sadrash1382-pixel/usb-voltmeter/README.md

# USB-Voltmeter – 24-Bit-DC-Spannungsmesser als Arduino-Shield
 
Ein selbst entwickeltes Präzisions-Spannungsmessgerät (±10 V DC) auf Basis des
24-Bit-Delta-Sigma-ADC **ADS1220**, aufgebaut als Shield für den Arduino Uno und
per **SCPI** über USB steuerbar – wie ein Labormessgerät.
 
Das Projekt deckt die komplette Entwicklungskette ab:
**Spezifikation → Simulation (LTspice) → Schaltplan & Layout (Altium) → Fertigung (JLCPCB)
→ Firmware → Kalibrierung & messtechnische Verifikation (Python/SCPI).**
 
> Status: 🟢 Platine Rev. 1 in Betrieb, per SCPI/PyVISA fernsteuerbar – Verstärkungskalibrierung und Rev. 2 offen
 
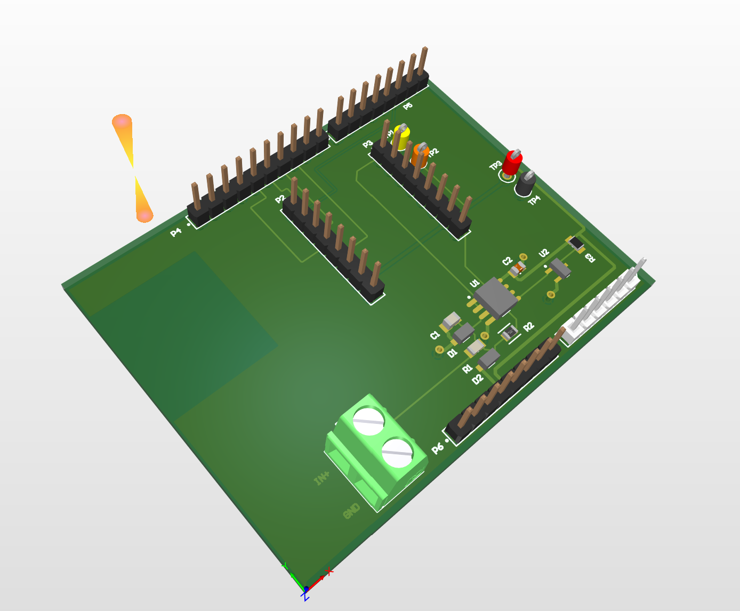
[picture p1: docs/img/shield_3d.png]
Shield 3D-Ansicht

 
---
 
## Spezifikation
 
| Parameter | Wert |
|---|---|
| Messbereich | ±10 V DC |
| Eingangswiderstand | 11 MΩ |
| ADC | TI ADS1220, 24 Bit, Delta-Sigma, interne Referenz 2,048 V |
| Netzbrummunterdrückung | 50/60 Hz simultan (Digitalfilter des ADS1220, 20 SPS) |
| Überspannungsschutz | Klemmdioden + strombegrenzender Eingangswiderstand |
| Schnittstelle | USB (virtueller COM-Port), SCPI-Befehle |
| Plattform | Arduino Uno R3 (Shield) |
 
## Schaltungskonzept
 
```
IN ──R1 10M──┬── NODE ──[U1A Puffer]── OUT ──► ADS1220 AIN0
             │                                    (differentiell)
           R2 1M   C1 10n   D1/D2 (Klemmung)
             │                                    
REF ◄──[U1B Puffer]── REF_RAW ◄── LM4040 2,5 V ──► ADS1220 AIN1
```
 
- **Teiler mit Fußpunkt an 2,5 V:** Bipolare Eingangsspannungen werden auf den
  Bereich 0…5 V der Einzelversorgung abgebildet.
  $V_\text{node} = V_\text{ref} + \frac{V_\text{in}-V_\text{ref}}{11}$
- **Differentielle Messung** zwischen OUT und REF:
  $V_\text{in} = 11 \cdot V_\text{diff} + V_\text{ref}$
- **CMOS-Puffer (MCP6002)** mit pA-Eingangsruhestrom, da der Knoten ≈ 0,91 MΩ
  Innenwiderstand hat.
- **RC-Tiefpass** aus Teiler-Innenwiderstand und C1 (C0G), f_g ≈ 17,5 Hz.
- **Kalibrierung:** $V_\text{kal} = a \cdot V_\text{roh} + b$ (Verstärkungs- und Offsetfehler).
## Simulation (LTspice)
 
Jede Stufe wurde einzeln simuliert und mit einer Handrechnung verglichen:
 
| Untersuchung | Ergebnis |
|---|---|
| DC-Übertragung des Teilers | ✅ wie berechnet |
| Einfluss Op-Amp-Eingangswiderstand (500 MΩ vs. 1 TΩ) | Verstärkungsfehler ±20 mV → ±50 µV |
| Einfluss Eingangsruhestrom (1 nA vs. 1 pA) | Offset 9 mV → 9 µV |
| Frequenzgang Filter | f_g = 17,66 Hz (berechnet 17,7 Hz) |
| Überspannung 30 V / 60 V | Knoten auf ≈ 5,2 / 5,3 V geklemmt, Diodenstrom ≈ 0,1 / 3 µA |
| Monte-Carlo, 0,1 %-Widerstände | Verstärkungsfehler bis ≈ 0,14 % → Kalibrierung nötig |
 
**Erkenntnis:** Das Fehlerbudget wird von Bauteiltoleranzen (mV-Bereich) dominiert,
nicht von der Schaltungstopologie (µV-Bereich).
 
> Hinweis: Simuliert wurde mit R1 = 9 MΩ (Teiler 1:10). Gefertigt wird mit R1 = 10 MΩ
> (Teiler 1:11, Eingangswiderstand 11 MΩ), weil 9,1 MΩ in 0805 nicht lieferbar war.
> Die Fehlermechanismen und Größenordnungen bleiben gleich.
 
Dateien und Plots: [`simulation/`](simulation/)
 
## Hardware
 
- Schaltplan: [`hardware/USB-Voltmeter_Schematic.pdf`](hardware/USB-Voltmeter_Schematic.pdf)
- Layout: 2 Lagen, 68,6 × 53,3 mm, durchgehende GND-Fläche auf der Unterseite,
  Sperrfläche über der USB-Buchse des Uno
- Stückliste: [`hardware/BOM.csv`](hardware/BOM.csv)
- Fertigungsdaten (Gerber/Drill für JLCPCB): [`hardware/fabrication/`](hardware/fabrication/)
- Passvorlage 1:1 zur mechanischen Prüfung auf dem Uno: [`hardware/fabrication/`](hardware/fabrication/)
| Oberseite | Unterseite |
|---|---|
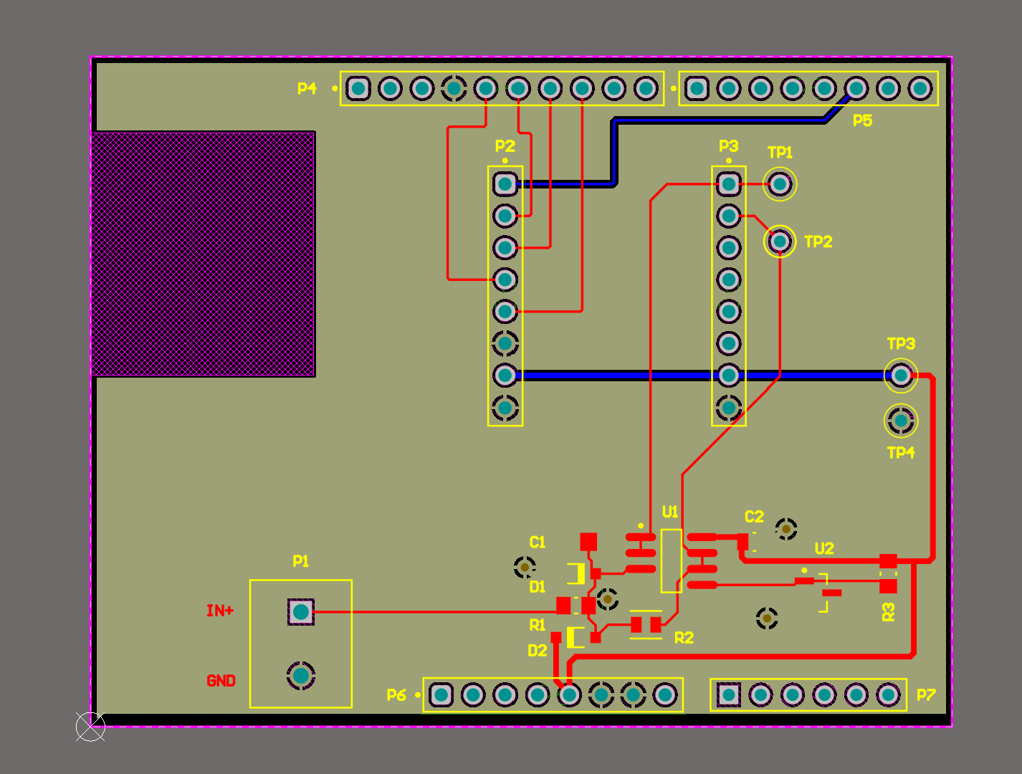
[picture p2: docs/img/layout_top.png]
Top
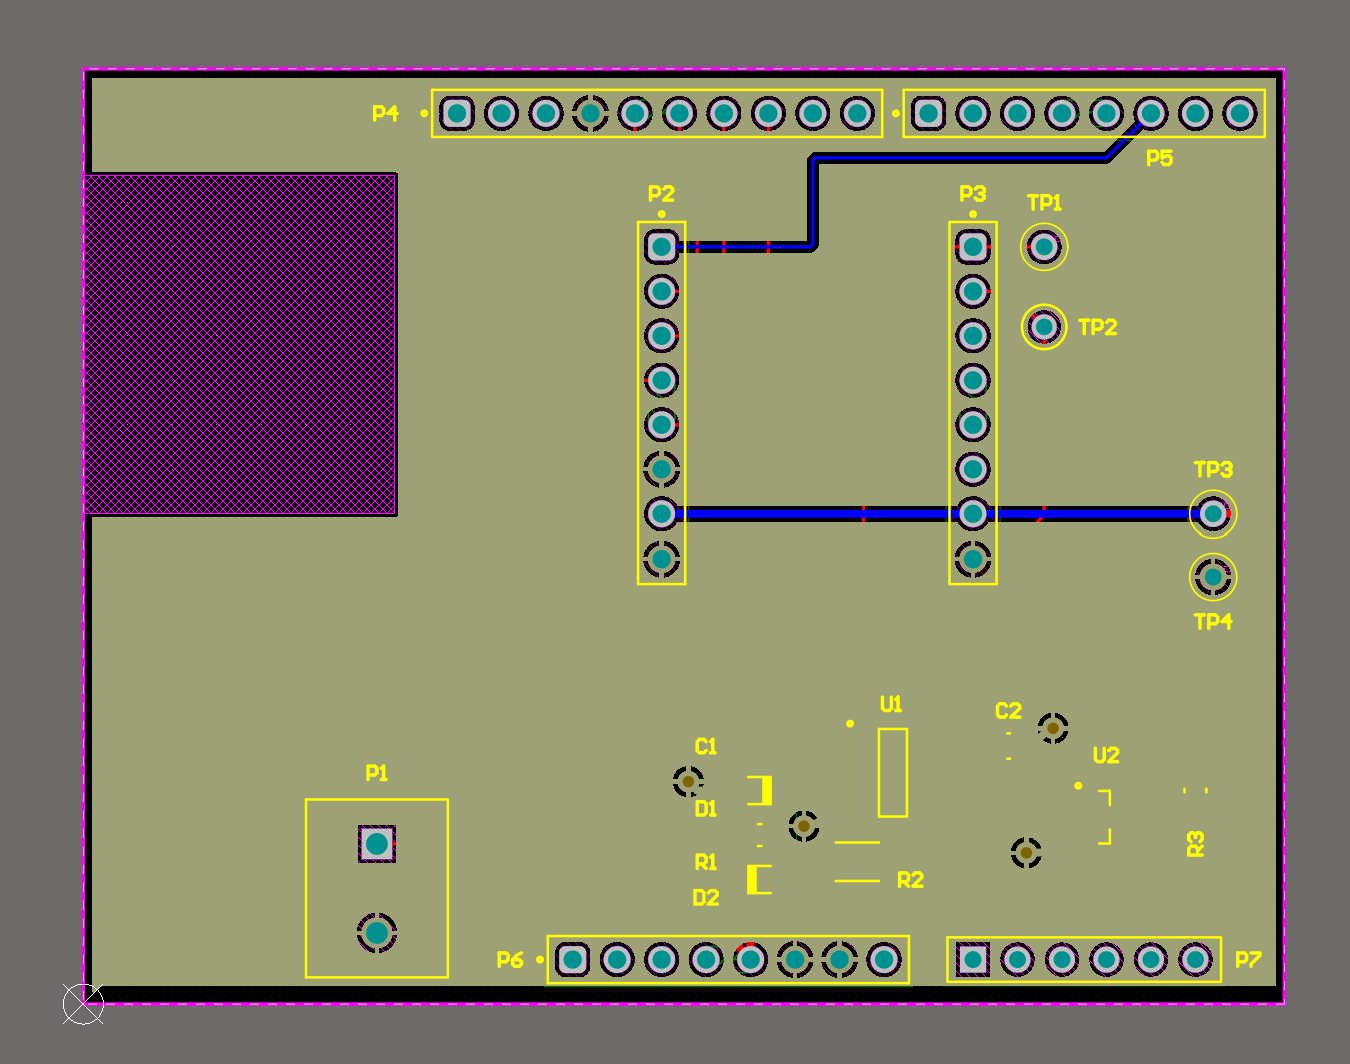
[picture p3: docs/img/layout_bottom.png]
Bottom
|  |  |
 
## Firmware
 
| Sketch | Zweck |
|---|---|
| [`firmware/spi_diagnose`](firmware/spi_diagnose) | SPI-Test ohne Library: Register schreiben/zurücklesen, läuft in Schleife zum Messen mit dem Oszilloskop |
| [`firmware/ads1220_test`](firmware/ads1220_test) | Messung AIN0 gegen AVSS, Ausgabe von Mittelwert und Rauschen |
| [`firmware/voltmeter_rev1`](firmware/voltmeter_rev1) | Firmware für Platine Rev. 1: Software-SPI (Workaround für Header-Versatz), differentielle Messung OUT − REF, Offset-Kalibrierung |
| [`firmware/voltmeter_scpi`](firmware/voltmeter_scpi) | **SCPI-Firmware:** misst auf Anfrage (`*IDN?`, `MEAS:VOLT:DC?`, `CALC:SDEV?`), Mittelung und Kalibrierung per Befehl, Kalibrierung im EEPROM, SCPI-Fehlerspeicher |

Befehlsübersicht und Automatisierung: [`docs/scpi-automatisierung.md`](docs/scpi-automatisierung.md)

**Python/PyVISA:** [`scripts/kennlinie.py`](scripts/kennlinie.py) steuert Labornetzteil (OWON SPE3051) und Voltmeter gemeinsam per SCPI, fährt eine Spannungsrampe und erzeugt CSV und Linearitätsplot.
 
## Messergebnisse
 
### Breadboard-Test des ADS1220 → [ausführlich](docs/breadboard-test.md)

| Messung | Ergebnis |
|---|---|
| Rauschen, Eingang kurzgeschlossen (20 SPS) | **3,5 µV<sub>rms</sub>** (Datenblatt: 3,89 µV<sub>rms</sub>) |
| Effektive Auflösung (2,048 V Bereich) | **≈ 19,2 Bit** rms, ≈ 16,5 Bit rauschfrei |
| Rauschen mit Labornetzteil am Eingang | ≈ 25 µV<sub>rms</sub> → von der Quelle dominiert |
| 0,5 V vom Netzteil | 499,94 mV (Multimeter: 500 mV) |

Bei der Inbetriebnahme wurde ein Kontaktfehler auf der MISO-Leitung mit dem
Oszilloskop eingegrenzt: SPI-Signale Schritt für Schritt vom Uno bis zum Chip und
zurück verfolgt.

### Platine Rev. 1 → [ausführlich](docs/inbetriebnahme-rev1.md)

| Messung | Ergebnis |
|---|---|
| Rauschen am Eingang (Einzelwandlung, 20 SPS) | **≈ 80 µV<sub>rms</sub>** |
| Effektive Auflösung (Messbereich ±10 V) | **≈ 17,9 Bit** |
| Offset vor / nach Kalibrierung | 17,1 mV / 0 mV |
| Abweichung zum Handmultimeter VC97 (1–9 V) | ≤ 9 mV, Verstärkung 0,15–0,19 % unter VC97 – innerhalb dessen Unsicherheit |

Rev. 1 hat einen Layoutfehler (Digitalheader 100 mil versetzt), der per Teilbestückung
und Software-SPI umgangen ist. Vier Bestückungs- und Kontaktfehler wurden über die
Testpunkte stufenweise eingegrenzt und behoben.

### Automatisierte Kennlinie → [ausführlich](docs/scpi-automatisierung.md)

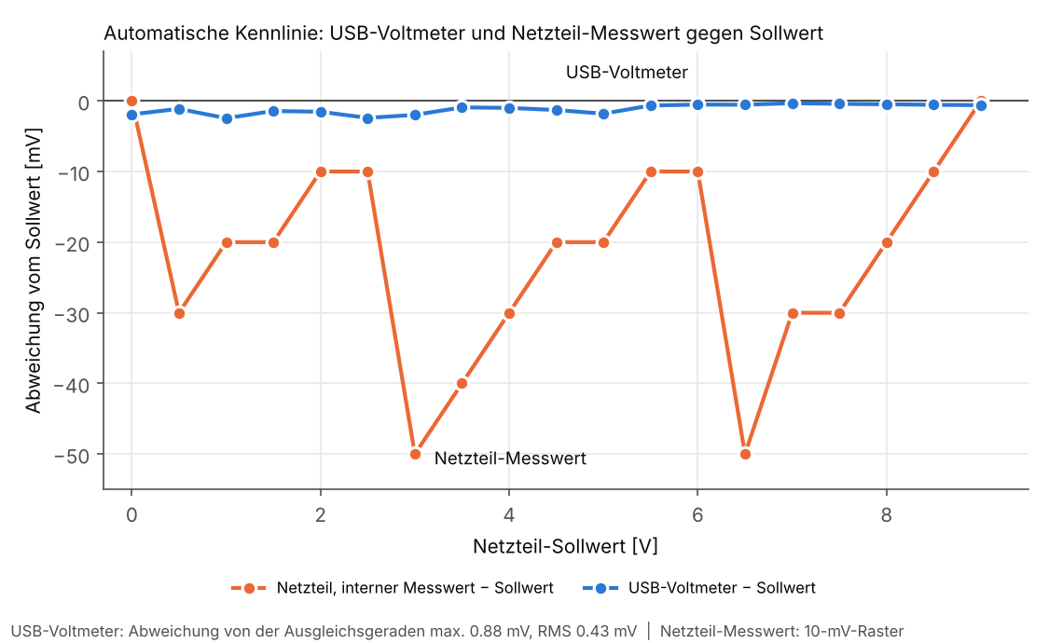
[picture p4: docs/img/rev1/kennlinie_auto.png]
Automatische Kennlinie


| Messung | Ergebnis |
|---|---|
| Nichtlinearität 0 … 9 V (gegen Netzteil-Sollwert) | **< 1 mV max., RMS 0,44 mV** in zwei Läufen, Obergrenze (Muster deutet auf den Netzteil-DAC) |
| Abweichung vom Netzteil-Sollwert | −2,5 … −0,3 mV |

Nebenbefund: Das Voltmeter ist genauer als die interne Spannungsmessung des
Netzteils (10-mV-Raster, Fehler bis −50 mV).

TODO – Verstärkungskalibrierung mit Tischmultimeter, negative Spannungen, Rev. 2
 
## Repository-Struktur
 
```
├── docs/            Konzept, Herleitungen, Bilder
├── simulation/      LTspice-Dateien (.asc) und Plots
├── hardware/        Altium-Projekt, Schaltplan-PDF, BOM, Gerber
├── firmware/        Arduino-Sketch
├── scripts/         Python: SCPI-Steuerung, Kalibrierung, Auswertung
└── measurements/    Rohdaten (.csv) und Auswertungen
```
 
## Autor
 
Amirsadra Shahanjarini – M.Sc. Elektrotechnik, TU München
