sadrash1382-pixel/usb-voltmeter/docs/img/ads1220_modul.jpg

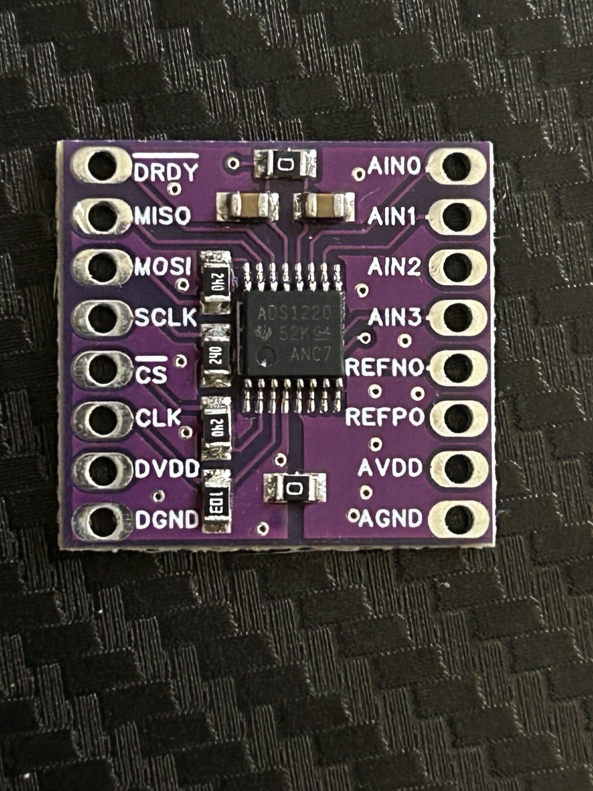
docs/img/ads1220_modul.jpg
