sadrash1382-pixel/usb-voltmeter/docs/img/bohrungen.png

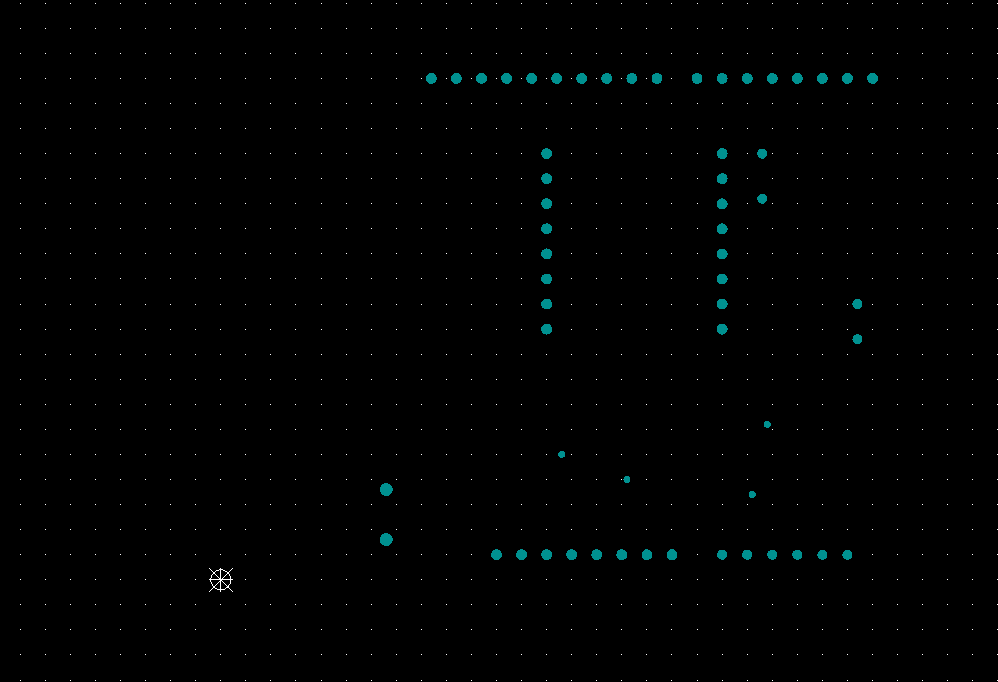
docs/img/bohrungen.png
