sadrash1382-pixel/usb-voltmeter/simulation/01_teiler_dc_sweep.png

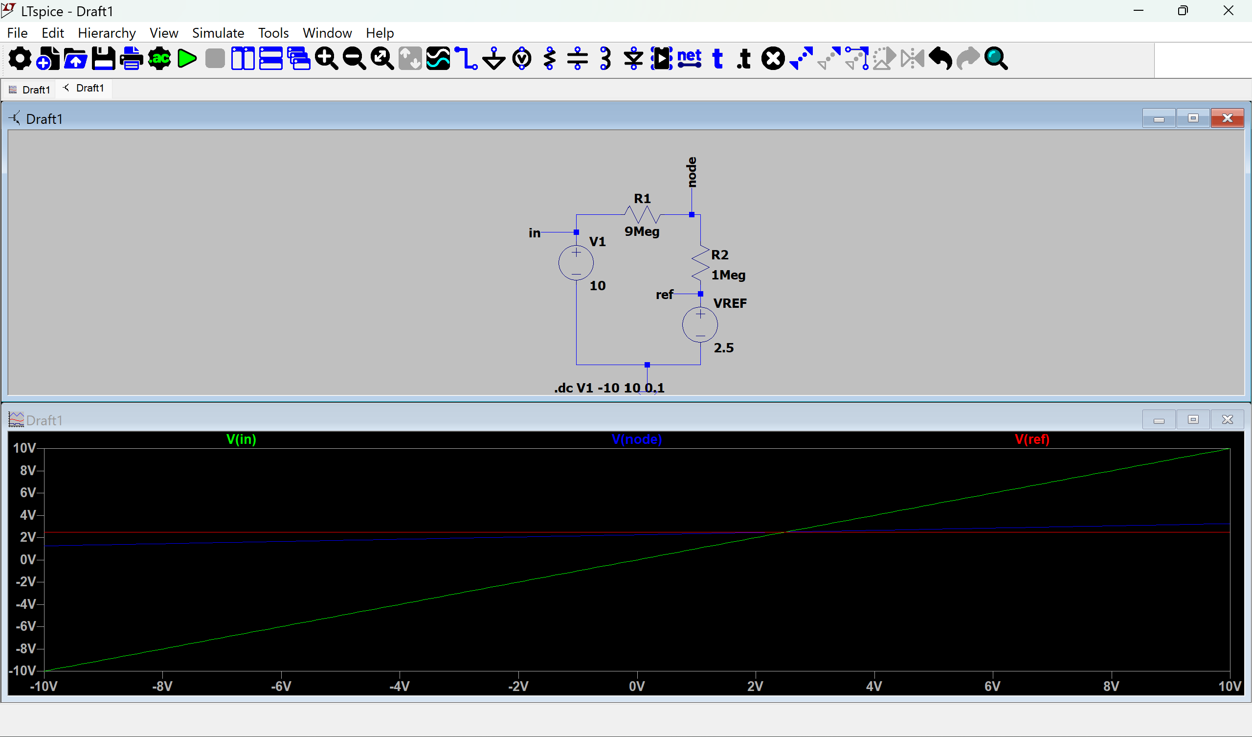
simulation/01_teiler_dc_sweep.png
