sadrash1382-pixel/usb-voltmeter/simulation/02_frontend_schaltung.png

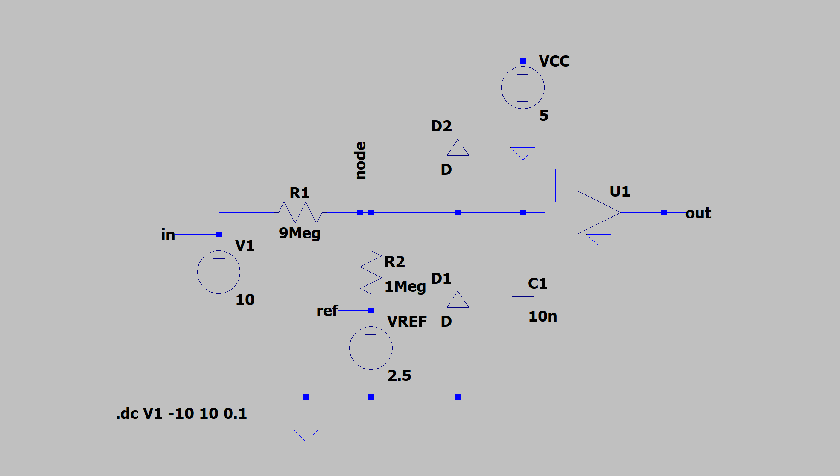
simulation/02_frontend_schaltung.png
