sadrash1382-pixel/usb-voltmeter/simulation/03_fehler_rin_500M.png

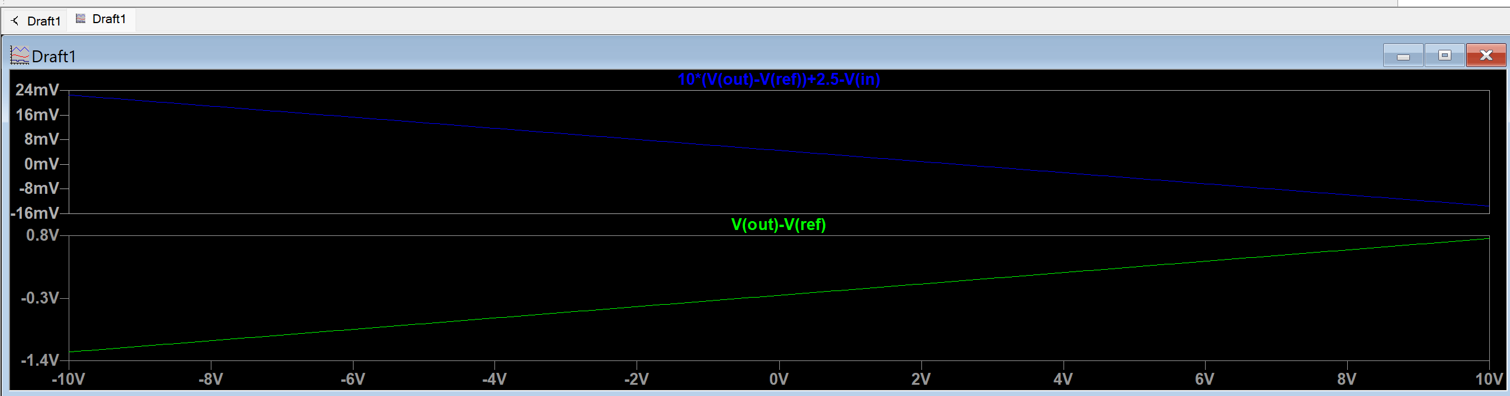
simulation/03_fehler_rin_500M.png
