sadrash1382-pixel/usb-voltmeter/simulation/04_fehler_rin_1T.png

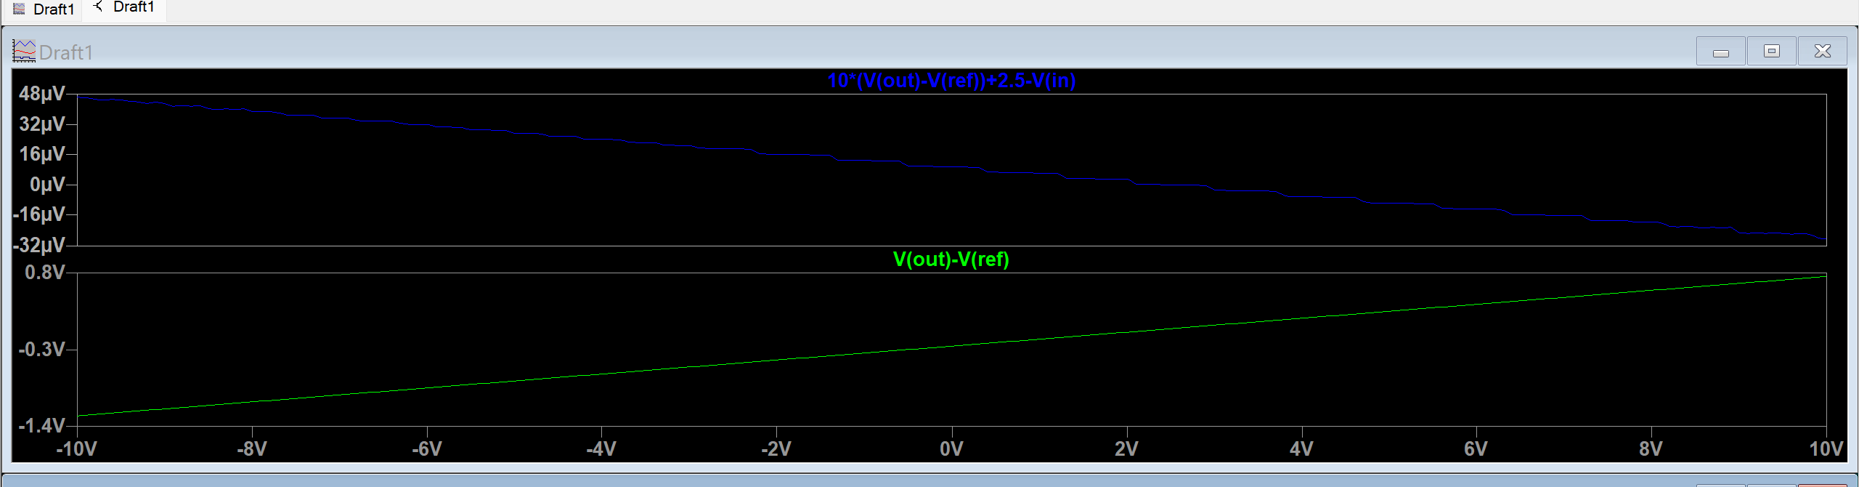
simulation/04_fehler_rin_1T.png
