sadrash1382-pixel/usb-voltmeter/simulation/05_offset_ib_1nA.png

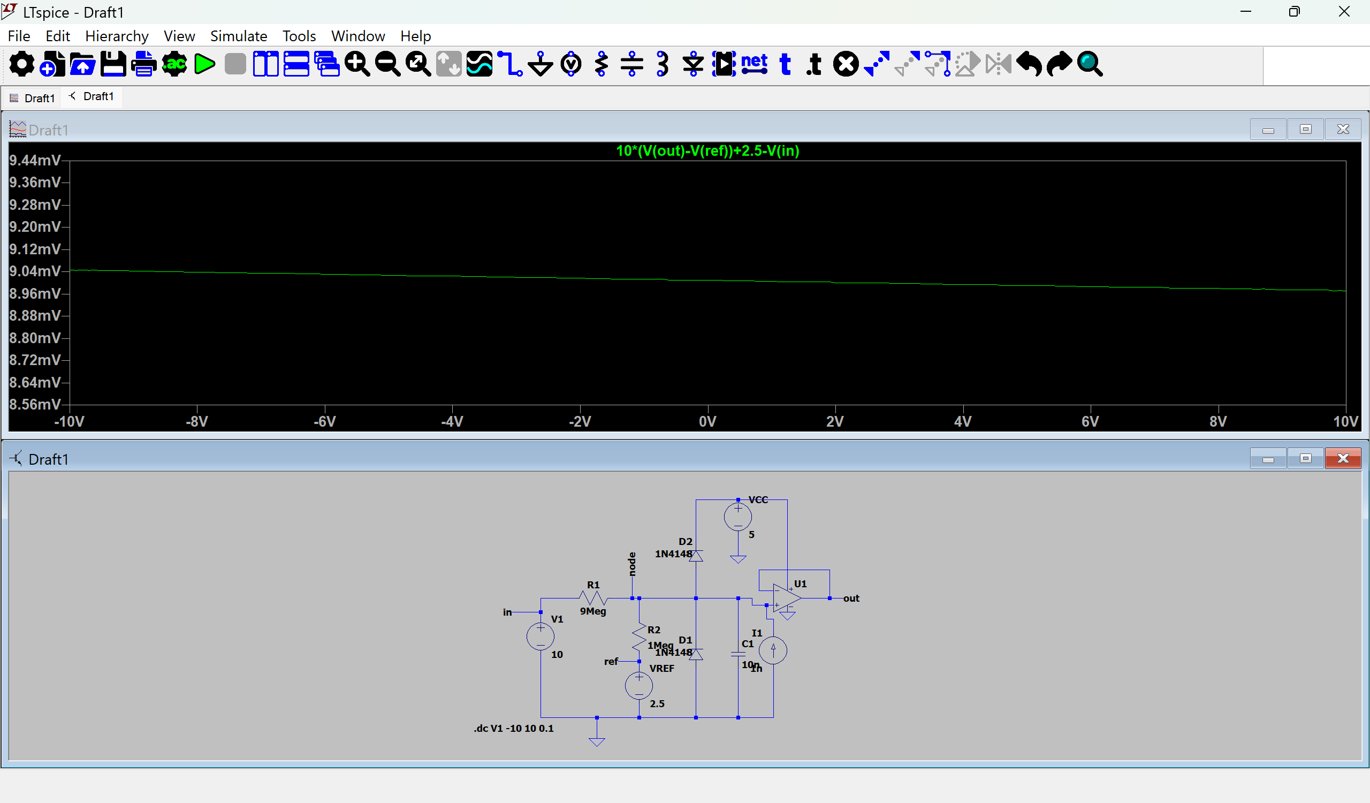
simulation/05_offset_ib_1nA.png
