sadrash1382-pixel/usb-voltmeter/simulation/06_offset_ib_1pA.png

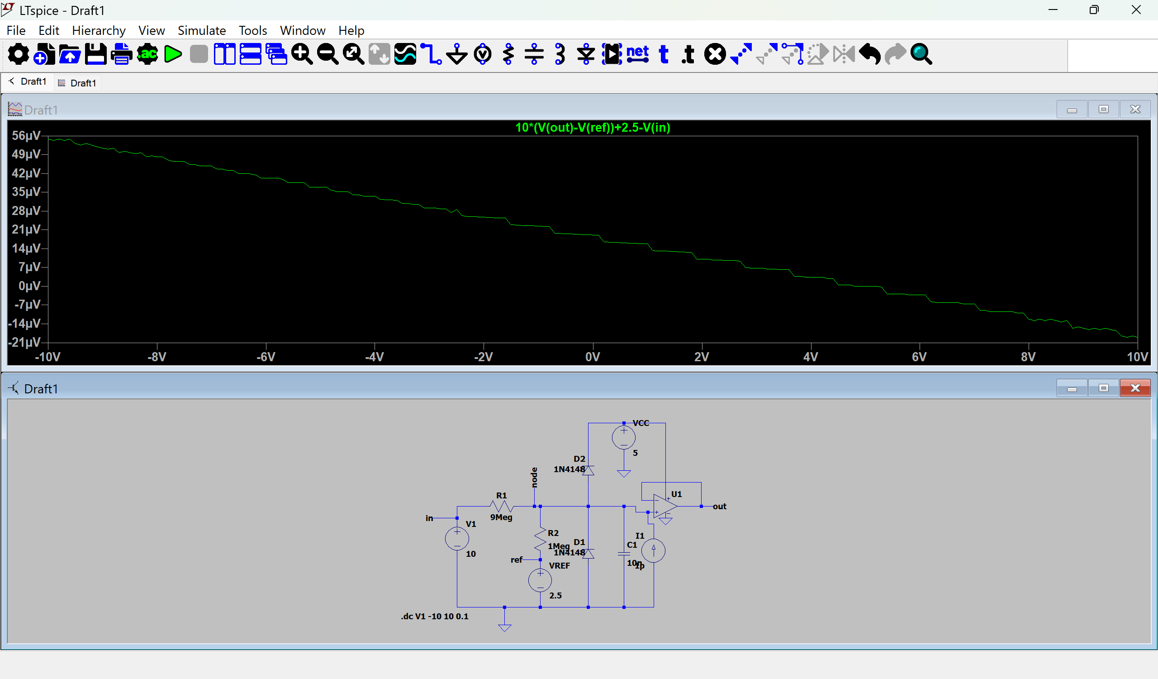
simulation/06_offset_ib_1pA.png
