sadrash1382-pixel/usb-voltmeter/simulation/07_ac_frequenzgang.png

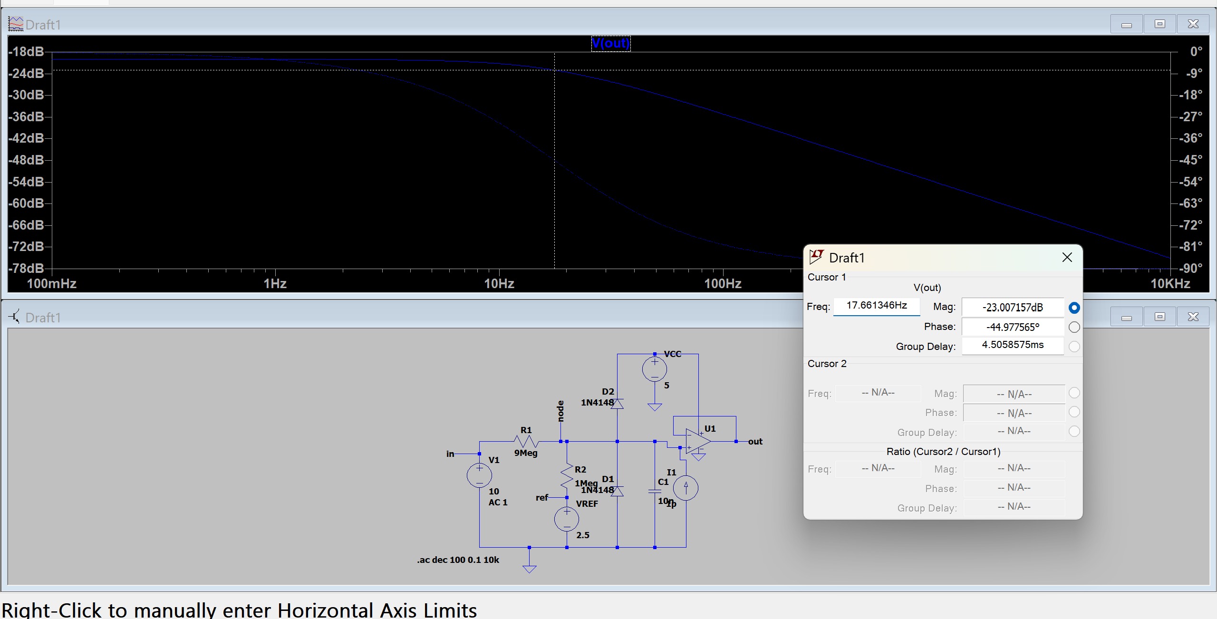
simulation/07_ac_frequenzgang.png
