sadrash1382-pixel/usb-voltmeter/simulation/08_transient_30V.png

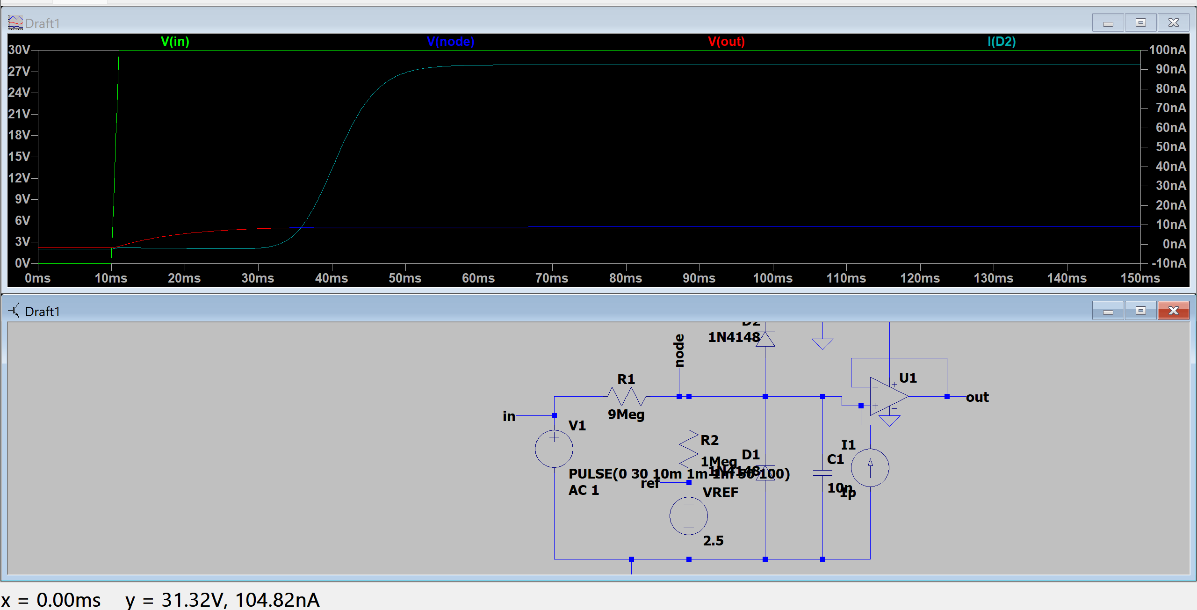
simulation/08_transient_30V.png
