sadrash1382-pixel/usb-voltmeter/simulation/09_transient_60V.png

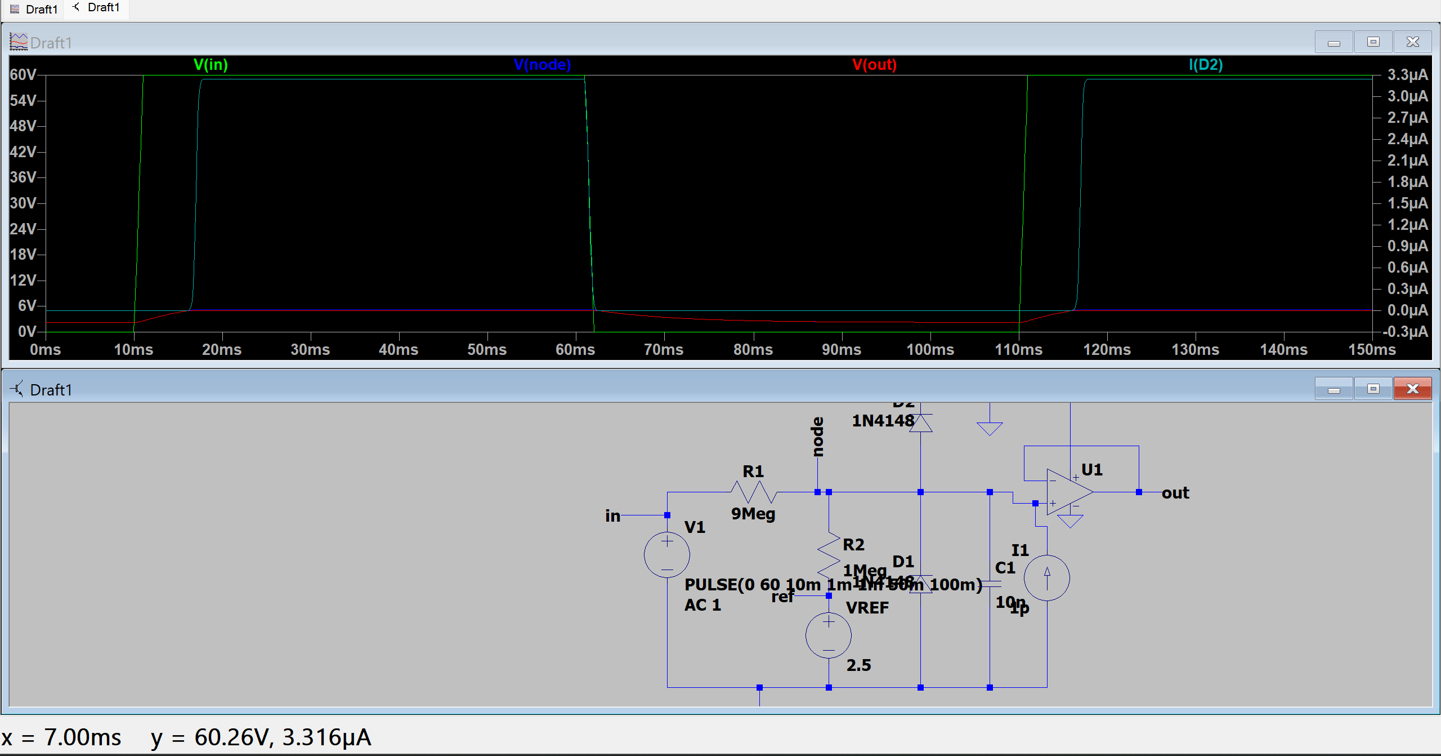
simulation/09_transient_60V.png
