sadrash1382-pixel/usb-voltmeter/simulation/10_monte_carlo.png

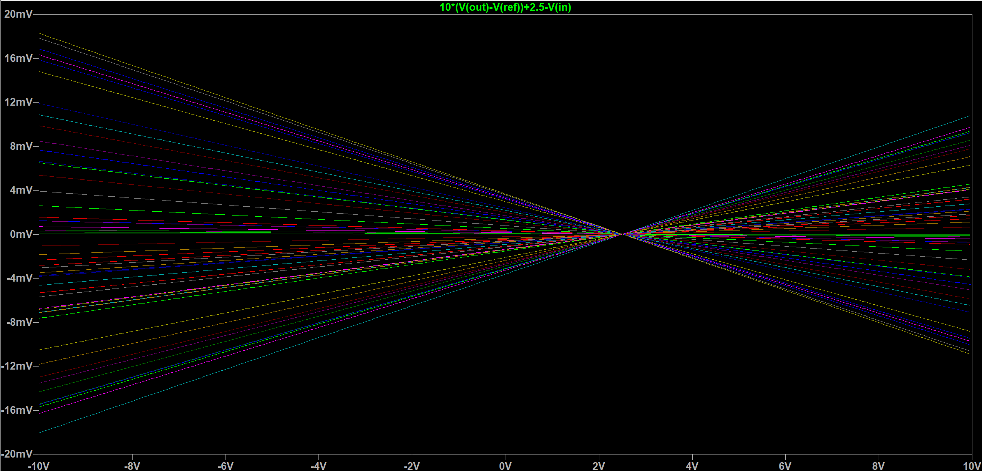
simulation/10_monte_carlo.png
