sadrash1382-pixel/usb-voltmeter/measurements/2026-11-13_kennlinie_auto.csv

# Automatische Kennlinie (scripts/kennlinie.py) | 13.11.2026
# Netzteil OWON SPE3051 (Sollwert und interner Messwert MEAS:VOLT?) | USB-Voltmeter Rev. 1 mit voltmeter_scpi (AVER:COUN 10)
# Ausgleichsgerade u_voltmeter = 1.000189 * u_soll + -2.006 mV; rest_mV = Abweichung davon
u_soll_V | u_netzteil_V | u_voltmeter_V | sdev_voltmeter_uV | rest_mV
0.000 | 0.000 | -0.001906 | 67.5 | 0.100
0.500 | 0.470 | 0.498874 | 44.6 | 0.785
1.000 | 0.980 | 0.997546 | 45.1 | -0.637
1.500 | 1.480 | 1.498570 | 87.4 | 0.293
2.000 | 1.990 | 1.998461 | 82.3 | 0.090
2.500 | 2.490 | 2.497587 | 53.5 | -0.879
3.000 | 2.950 | 2.998019 | 66.3 | -0.541
3.500 | 3.460 | 3.499078 | 64.2 | 0.424
4.000 | 3.970 | 3.999005 | 65.9 | 0.256
4.500 | 4.480 | 4.498706 | 79.0 | -0.137
5.000 | 4.980 | 4.998189 | 81.4 | -0.748
5.500 | 5.490 | 5.499347 | 73.9 | 0.315
6.000 | 5.990 | 5.999475 | 84.3 | 0.349
6.500 | 6.450 | 6.499458 | 71.9 | 0.238
7.000 | 6.970 | 6.999671 | 104.6 | 0.356
7.500 | 7.470 | 7.499579 | 106.9 | 0.170
8.000 | 7.980 | 7.999519 | 69.7 | 0.016
8.500 | 8.490 | 8.499444 | 94.1 | -0.153
9.000 | 9.000 | 8.999395 | 94.3 | -0.297
