sadrash1382-pixel/usb-voltmeter/measurements/2026-11-13_kennlinie_auto_lauf2.csv

# Kennlinie USB-Voltmeter | 2026-11-13 11:29
# Mittelung 10 Wandlungen | Einschwingzeit 1.0 s
# Ausgleichsgerade u_voltmeter = 1.000189 * u_soll + -1.902 mV
# rest_mV = Abweichung von der Ausgleichsgeraden (Nichtlinearitaet)
u_soll_V | u_netzteil_V | u_voltmeter_V | sdev_voltmeter_uV | rest_mV
0.000000 | 0.000000 | -0.001878 | 83.200000 | 0.023805
0.500000 | 0.490000 | 0.498960 | 53.500000 | 0.767137
1.000000 | 0.990000 | 0.997612 | 65.700000 | -0.675532
1.500000 | 1.450000 | 1.498696 | 60.800000 | 0.313800
2.000000 | 1.960000 | 1.998623 | 52.600000 | 0.146132
2.500000 | 2.470000 | 2.497657 | 68.700000 | -0.914537
3.000000 | 2.970000 | 2.998149 | 51.000000 | -0.517205
3.500000 | 3.480000 | 3.499228 | 60.000000 | 0.467126
4.000000 | 3.980000 | 3.999048 | 69.800000 | 0.192458
4.500000 | 4.490000 | 4.498666 | 155.100000 | -0.284211
5.000000 | 4.950000 | 4.998481 | 88.000000 | -0.563879
5.500000 | 5.470000 | 5.499620 | 88.100000 | 0.480453
6.000000 | 5.980000 | 5.999604 | 80.000000 | 0.369784
6.500000 | 6.480000 | 6.499620 | 118.700000 | 0.291116
7.000000 | 6.990000 | 6.999714 | 85.100000 | 0.290447
7.500000 | 7.490000 | 7.499763 | 95.500000 | 0.244779
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
