sadrash1382-pixel/usb-voltmeter/hardware/USB-Voltmeter_Schematic.pdf

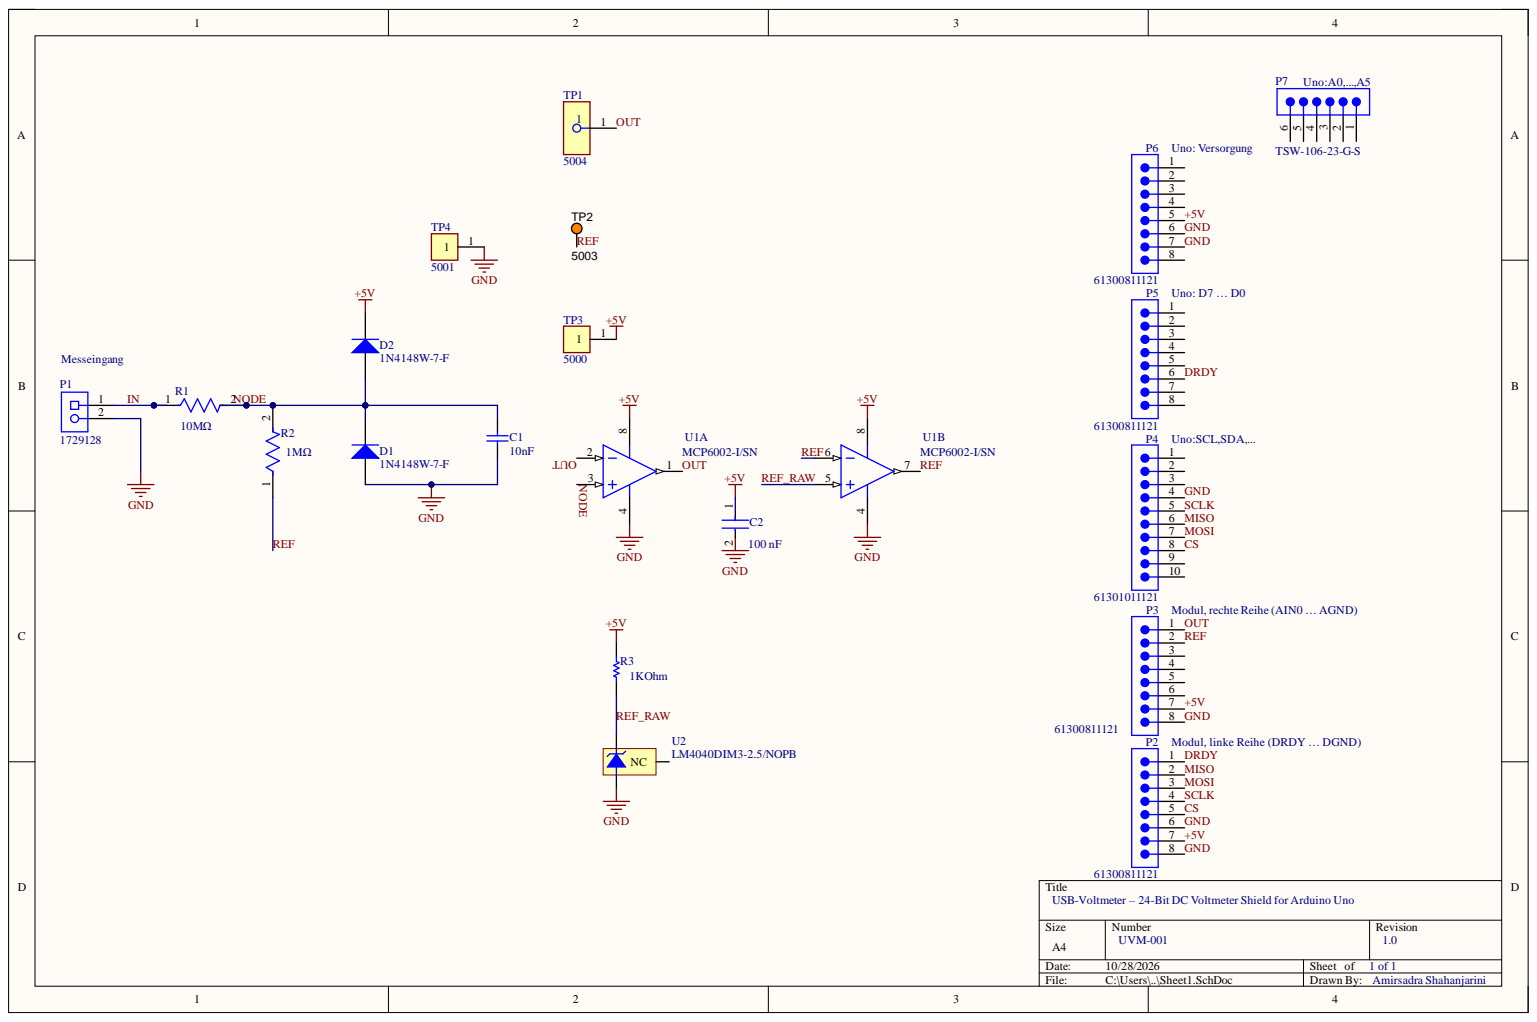
[picture p24: page 1]

MISO DRDY GND GND
