sadrash1382-pixel/usb-voltmeter/hardware/fabrication/passvorlage_1zu1.pdf

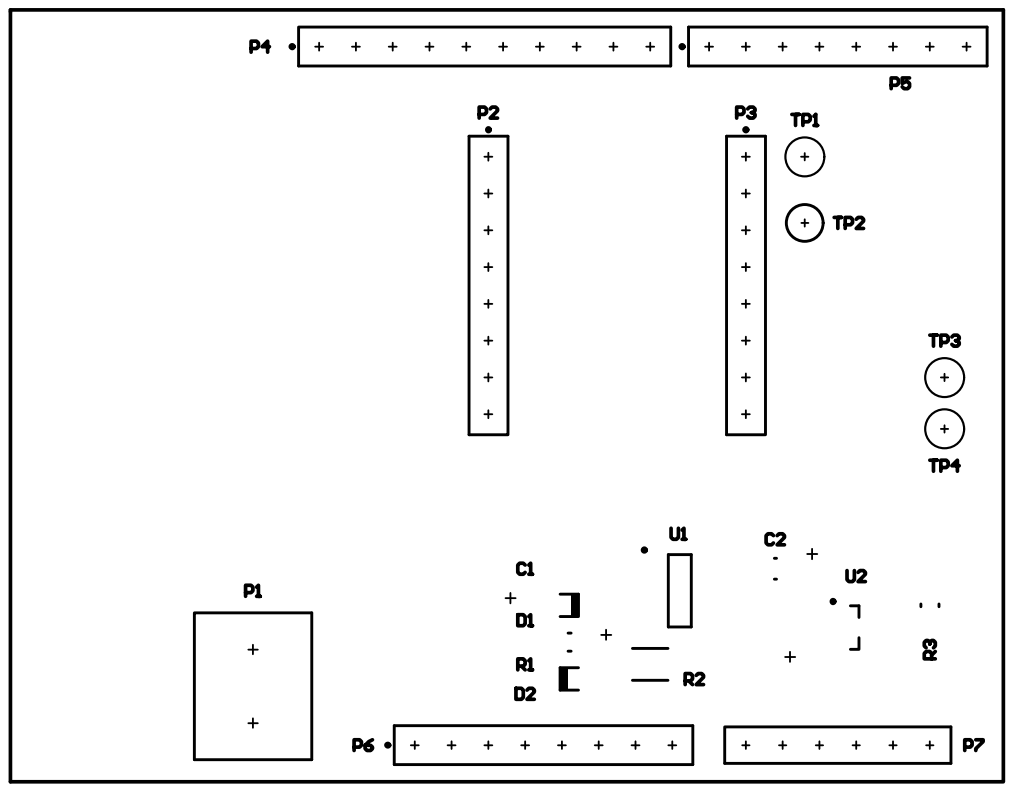
[picture p25: page 1]
