sadrash1382-pixel/usb-voltmeter/simulation/frontend.asc

C1: cap; 10n
D1: diode; 1N4148
D2: diode; 1N4148
I1: current; 1p
R1: res; {mc(9Meg,0.001)}; tol=0.1
R2: res; {mc(1Meg,0.001)}
U1: UniversalOpAmp2
V1: voltage; 10; AC 0
VCC: voltage; 5
VREF: voltage; 2.5
Named nets: 0, in, ref, node, out
.dc V1 -10 10 0.1
.step param run 1 50 1
