sadrash1382-pixel/usb-voltmeter/(list of files, drawings)

Other design files:
hardware/PCB2.PcbDoc
hardware/Sheet1.SchDoc
hardware/USB-Voltmeter.PrjPcb
