sadrash1382-pixel/usb-voltmeter/(commit log)

2026-10-28 Rename hardware/Project Outputs for USB-Voltmeter.zip to hardware/fabrication/gerber_jlcpcb.zip
2026-10-28 Rename hardware/Voltmeter PCB.pdf to hardware/fabrication/passvorlage_1zu1.pdf
2026-11-01 Breadboard-Test des ADS1220 dokumentieren
    Fehlersuche mit Oszilloskop, Rauschmessung, Firmware-Sketche und Messdaten.
    Claude-Session: https://claude.ai/code/session_01JDt4A8c54rJWL2dZfXYkfH
    [2026-11-01_breadboard.csv]
2026-11-13 Inbetriebnahme Platine Rev. 1 dokumentieren
    Erratum Header-Versatz mit Software-SPI-Workaround, Fehlersuche, Offset-Kalibrierung,
    Vergleich mit VC97, Rauschen, Firmware voltmeter_rev1 und Messdaten.
    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
    [2026-11-13_rev1_kennlinie.csv]
2026-11-13 Inbetriebnahme Rev. 1: Erkenntnis zur Diodenpolung präzisieren
    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
2026-11-13 SCPI-Firmware und PyVISA-Automatisierung
    voltmeter_scpi (SCPI-Befehle, Kalibrierung im EEPROM, Fehlerspeicher),
    scripts/kennlinie.py (Netzteil + Voltmeter per PyVISA), automatische Kennlinie
    mit CSV und Plot, Doku docs/scpi-automatisierung.md, README aktualisiert.
    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
    [2026-11-13_kennlinie_auto.csv]
2026-11-13 Zweiten automatischen Lauf ergänzen, Wiederholbarkeit auswerten
    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
    [2026-11-13_kennlinie_auto_lauf2.csv]
